jsphuebner/bms-hardware/README.md

# bms-hardware
Hardware design files for Lithium BMS

# License
Attribution-ShareAlike 4.0 International
https://creativecommons.org/licenses/by-sa/4.0/legalcode

You musn't change the copyright info (J. Huebner/A. Martell and openinverter.org) on the silkscreen in size location or content.
