jsphuebner/bms-hardware/BMS Slave Files/BatMeas5.3 Manufacturing Files/Assembly/BOM.csv

Qty | Value | SM / THT | Fitted (Y/N) | Device | Package | Parts | Description | Additional info | Manufacturer | Manufacturers Part Number | Comment | Mouser / Farnell
2 |  | SM | Y | DIODESOD-323F | SOD-323F | D2, D3 | Diode | Diode Signal 1N4148 | On Semiconductor | 1N4148WS |  | https://www.mouser.co.uk/ProductDetail/ON-Semiconductor-Fairchild/1N4148WS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
1 |  | SM | Y | CON-LSTC |  | X1_ | Chinese IDC connector | 4mm wire to board connector | LSTC | 4400W03J7923
1 |  | SM | Y | BM05B-PASS-1 |  | J4 | JST Connector |  | JST | BM05B-PASS-1-TFT(LF)(SN) |  | https://uk.farnell.com/jst-japan-solderless-terminals/bm05b-pass-1-tft-lf-sn/connector-header-5pos-1row-2mm/dp/2399310
1 |  | SM | N | CON-AVX |  | X1 | AVX IDC connector | 2.56mm wire to board connector | AVX | 9175003702996 |  | https://www.digikey.com/product-detail/en/avx-corporation/009175003702996/478-9530-1-ND/5015640
1 |  | SM | Y | PINHD-2X5 | 2X05 | JP1 | PIN HEADER | Header 10 way |  | 3020-10-0300-00 | Programming header | https://www.digikey.de/product-detail/de/cnc-tech/3020-10-0300-00/1175-1621-ND/3441727
1 | 47k | SM | Y | R-EU_R0603 | R0603 | R14 | RESISTOR, European symbol | Resistor 0603 100k 1% 100mW | Vishay | CRCW0603100KFKEA |  | https://lcsc.com/product-detail/Chip-Resistor-Surface-Mount_Uniroyal-Elec-0603WAF4702T5E_C25819.html/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
4 | 100n | SM | Y | C-EUC0603 | C0603 | C2, C3, C4 | CAPACITOR, European symbol | Capacitor 0603 100n 20% 25V | Kemet | C0603C104M3VACTU |  | https://www.mouser.co.uk/ProductDetail/KEMET/C0603C104M3VACTU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
1 | 10µ | SM | Y | C-EUC0805 | C0805 | C9 | CAPACITOR, European symbol | Capacitor 0805 10uF 10% 10V | Kemet | C0805C106K8PACTU |  | https://www.mouser.co.uk/ProductDetail/KEMET/C0805C106K8PACTU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
4 | 150060GS75000 | SM | Y | LEDCHIPLED_0805 | CHIPLED_0805 | LED1, LED2, LED3, LED4 | LED | LED 0805 Red | Wurth | 150080RS75000 |  | https://www.mouser.co.uk/ProductDetail/Wurth-Electronics/150080RS75000
1 | 1540k | SM | Y | R-EU_R0603 | R0603 | R8 | RESISTOR, European symbol | Resistor 0603 1540k 1% 100mW | Vishay | CRCW06031M54FKEA |  | https://www.mouser.co.uk/ProductDetail/Vishay-Dale/CRCW06031M54FKEA?qs=algJsbUzQnFVJ2u3pqZ3aw%3D%3D
4 | 1M | SM | Y | R-EU_R0603 | R0603 | R1, R2, R3, R4 | RESISTOR, European symbol | Resistor 0603 1M 1% 100mW | Vishay | CRCW06031M00FKEA |  | https://www.mouser.co.uk/ProductDetail/Vishay-Dale/CRCW06031M00FKEA
2 | 4k7 | SM | Y | R-EU_R0603 | R0603 | R6, R16 | RESISTOR, European symbol | Resistor 0603 1k 5% 100mW | Vishay | CRCW06031K00FKEA |  | https://lcsc.com/product-detail/Chip-Resistor-Surface-Mount_Uniroyal-Elec-0603WAF4701T5E_C23162.html/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
3 | 1µ | SM | Y | C-EUC0603 | C0603 | C1, C6, C7, C8 | CAPACITOR, European symbol | Capacitor 0603 1u 20% 25V | Kemet | C0603C105M3PACTU |  | https://www.mouser.co.uk/ProductDetail/KEMET/C0603C105M3PACTU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
1 | 20V | SM | Y | ZENER-DIODESMB | SMB | D1 | Z-Diode | Zener Diode SMB 20V 3W | On Semiconductor | 1SMB5932BT3G |  | https://www.mouser.co.uk/ProductDetail/ON-Semiconductor/1SMB5932BT3G?qs=sGAEpiMZZMtqO%252BWUGLBzeNjTlo8%2FRK9r
4 | 22 | SM | Y | R-EU_R0805 | R0805 | R19, R20, R21, R22 | RESISTOR, European symbol | Resistor 0805 22R 5% 125mW | Vishay | CRCW080522R0FKEA |  | https://www.mouser.co.uk/ProductDetail/Vishay-Dale/CRCW080522R0FKEA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
3 | 220 | SM | Y | R-EU_R0603 | R0603 | R11, R12, R13 | RESISTOR, European symbol | Resistor 0603 270R 5% 100mW | Vishay | CRCW0603270RFKEA | Used to be 270 | https://www.mouser.co.uk/ProductDetail/Vishay-Dale/CRCW0603270RFKEA
1 | 270k | SM | Y | R-EU_R0603 | R0603 | R7 | RESISTOR, European symbol | Resistor 0603 270k 1% 100mW | Vishay | CRCW0603270KFKEA |  | https://www.mouser.co.uk/ProductDetail/Vishay-Dale/CRCW0603270KFKEA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
1 | 2M8 | SM | Y | R-EU_R0603 | R0603 | R9 | RESISTOR, European symbol | Resistor 0603 2M8 1% 100mW | Vishay | CRCW06032M80FKEA |  | https://www.mouser.co.uk/ProductDetail/Vishay-Dale/CRCW06032M80FKEA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
1 | 3V | SM | Y | V_REG_LDOSMD | SOT23-5 | IC3 | Voltage Regulator LDO | Regulator LDO SOT23-5 3V 300mA | Microchip | AP2139AK-3.0TRG1 | AP2139AK-3.0TRG1 has less GND current (1µA vs. 50µA) but costs twice as much as MIC5501-3.0YM5-TR, but gnd current important | https://www.mouser.co.uk/ProductDetail/Diodes-Incorporated/AP2139AK-30TRG1
1 | 3V3 | SM | Y | V_REG_LDOSMD | SOT23-5 | IC2 | Voltage Regulator LDO | Regulator LDO SOT23-5 3V3 300mA | Microchip | AP2204K-3.3TRG1 | Must have > 20V input voltage | https://www.mouser.co.uk/ProductDetail/Diodes-Incorporated/AP2139AK-30TRG1
1 | 4M12 | SM | Y | R-EU_R0603 | R0603 | R10 | RESISTOR, European symbol | Resistor 0603 4M12 1% 100mW | Vishay | CRCW06034M12FKEA |  | https://www.mouser.co.uk/ProductDetail/Vishay-Dale/CRCW06034M12FKEA
1 | 1n | SM | Y | C-EUC0603 | C0603 | C5 | CAPACITOR, European symbol | Capacitor 0603 1n 20% 25V | Kemet | C0603C103K4RECAUTO |  | https://lcsc.com/product-detail/Multilayer-Ceramic-Capacitors-MLCC-SMD-SMT_SAMSUNG_CL10B102KB8NNNC_1nF-102-10-50V_C1588.html/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
1 | ATTINY44A-SSU | SM | Y | ATTINY44 | SO014 | IC1 |  | Microcontroller ATTINYxxxx | Microchip / Atmel | ATTINY44A-SSU |  | https://www.mouser.de/ProductDetail/Microchip-Technology-Atmel/ATTINY44A-SSU
3 | MMUN2111LT1G | SM | Y | MUN2111T1-PNP_DRIVER-SC59-B | EC SC59-BEC | T4, T5, T6 | PNP Bias Resistor Transistor | Transistor PNP | On Semiconductor | MMUN2111LT1G |  | https://www.mouser.co.uk/ProductDetail/ON-Semiconductor/MMUN2111LT1G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
5 | MMUN2233 | SM | Y | MUN2211T1-NPN_DRIVER-SC59-B | EC SC59-BEC | T1, T2, T3, T7, T8 | NPN Bias Resistor Transistor | Transistor NPN | On Semiconductor | MMUN2233LT1G |  | https://www.mouser.co.uk/ProductDetail/ON-Semiconductor/MMUN2233LT1G
1 |  | SM | Y | Jumper |  | JP1 | Board position selection |  | Sullins | QPC02SXGN-RC | Place on JP1 Pins 2-4 by default. Must be moved to Pins 4-6 on first board | https://www.digikey.de/product-detail/de/sullins-connector-solutions/QPC02SXGN-RC/S9337-ND/2618262
 |  | 48 SMT Parts
 |  | 24 Different SMT parts
 |  |  |  |  |  |  |  |  | Mating parts
 |  |  |  |  |  |  |  |  | JST | PAP-03V-S |  | https://uk.farnell.com/jst-japan-solderless-terminals/pap-03v-s/connector-housing-pa-3way-2mm/dp/1830728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
 |  |  |  |  |  |  |  |  | JST | PAP-05V-S |  | https://uk.farnell.com/jst-japan-solderless-terminals/pap-05v-s/connector-housing-rcpt-5pos-1row/dp/2399185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
 |  |  |  |  |  |  |  |  | JST | SPHD-002T-P0.5 | 28-24AWG | https://uk.farnell.com/jst-japan-solderless-terminals/sphd-002t-p0-5/crimp-socket-24-28awg/dp/1830725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
 |  |  |  |  |  |  |  |  | Crimp tool | SN-28B | Something like this from Ebay | https://www.ebay.co.uk/itm/SN-28B-2-54mm-3-96mm-Pin-Crimp-Plier-Tool-18-28AWG-Crimper-for-Dupont-JST-UK/123777029100
