jsphuebner/bms-hardware/BatMeas5.2.csv

Qty | Value | SM / THT | Fitted (Y/N) | Device | Package | Parts | Description | Additional info | Fitted? | Manufacturer | Manufacturers Part Number | Comment | Mouser / Farnell
1 |  | SM | Y | DIODESOD-323F | SOD-323F | D2 | Diode | Diode Signal 1N4148 | Y | On Semiconductor | 1N4148WS |  | https://www.mouser.co.uk/ProductDetail/ON-Semiconductor-Fairchild/1N4148WS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
1 |  | SM | Y | DIODESOD-323F | SOD-323F | D3 | Zener Diode | Zener Diode SOD-323 3V 300mW | Y | On Semiconductor | MM3Z3V0ST1G
1 |  | SM | Y | BM03B-PASS-1 |  | J4 | JST Connector |  | Y | JST | BM03B-PASS-1-TFT(LF)(SN) |  | https://uk.farnell.com/jst-japan-solderless-terminals/bm03b-pass-1-tft-lf-sn/connector-header-3pos-1row-2mm/dp/2399307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
1 |  | SM | Y | BM05B-PASS-1 |  | J3 | JST Connector |  | Y | JST | BM05B-PASS-1-TFT(LF)(SN) |  | https://uk.farnell.com/jst-japan-solderless-terminals/bm05b-pass-1-tft-lf-sn/connector-header-5pos-1row-2mm/dp/2399310
1 |  | THT | N | MTA03-100 | 10X03MTA | J2 | AMP connector | Connector 3 pole | N
1 |  | THT | N | MTA05-100 | 10X05MTA | J1 | AMP connector | Connector 5 pole | N
1 |  | THT | N | PINHD-2X5 | 2X05 | JP1 | PIN HEADER | Header 10 way | N |  |  | Programming header - not fitted
1 | 100k | SM | Y | R-EU_R0603 | R0603 | R14 | RESISTOR, European symbol | Resistor 0603 100k 1% 100mW | Y | Vishay | CRCW0603100KFKEA |  | https://www.mouser.co.uk/ProductDetail/Vishay-Dale/CRCW0603100KFKEA
4 | 100n | SM | Y | C-EUC0603 | C0603 | C2, C3, C4, C6 | CAPACITOR, European symbol | Capacitor 0603 100n 20% 25V | Y | Kemet | C0603C104M3VACTU |  | https://www.mouser.co.uk/ProductDetail/KEMET/C0603C104M3VACTU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
1 | 10µ | SM | Y | C-EUC0805 | C0805 | C9 | CAPACITOR, European symbol | Capacitor 0805 10uF 10% 10V | Y | Kemet | C0805C106K8PACTU |  | https://www.mouser.co.uk/ProductDetail/KEMET/C0805C106K8PACTU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
4 | 150060GS75000 | SM | Y | LEDCHIPLED_0805 | CHIPLED_0805 | LED1, LED2, LED3, LED4 | LED | LED 0805 Red | Y | Wurth | 150080RS75000 |  | https://www.mouser.co.uk/ProductDetail/Wurth-Electronics/150080RS75000
1 | 1540k | SM | Y | R-EU_R0603 | R0603 | R8 | RESISTOR, European symbol | Resistor 0603 1540k 1% 100mW | Y | Vishay | CRCW06031M54FKEA |  | https://www.mouser.co.uk/ProductDetail/Vishay-Dale/CRCW06031M54FKEA?qs=algJsbUzQnFVJ2u3pqZ3aw%3D%3D
4 | 1M | SM | Y | R-EU_R0603 | R0603 | R1, R2, R3, R4 | RESISTOR, European symbol | Resistor 0603 1M 1% 100mW | Y | Vishay | CRCW06031M00FKEA |  | https://www.mouser.co.uk/ProductDetail/Vishay-Dale/CRCW06031M00FKEA
2 | 1k | SM | Y | R-EU_R0603 | R0603 | R6, R13 | RESISTOR, European symbol | Resistor 0603 1k 5% 100mW | Y | Vishay | CRCW06031K00FKEA | Remove R6 on first board | https://www.mouser.co.uk/ProductDetail/Vishay-Dale/CRCW06031K00FKEA
1 | 1k | SM | N | R-EU_R0603 | R0603 | R5 | RESISTOR, European symbol | Resistor 0603 1k 5% 100mW | Y | Vishay | CRCW06031K00FKEA | Do not populate R5, only on first board in UK. | https://www.mouser.co.uk/ProductDetail/Vishay-Dale/CRCW06031K00FKEA
1 | 1µ | SM | Y | C-EUC0603 | C0603 | C1 | CAPACITOR, European symbol | Capacitor 0603 1u 20% 25V | Y | Kemet | C0603C105M3PACTU |  | https://www.mouser.co.uk/ProductDetail/KEMET/C0603C105M3PACTU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
1 | 1µ | SM | Y | C-EUC0805 | C0805 | C8 | CAPACITOR, European symbol | Capacitor 0805 1uF 20% 10V | Y | Kemet | C0805C105K8RAC |  | https://www.mouser.co.uk/ProductDetail/KEMET/C0805C105K8RAC
1 | 20V | SM | Y | ZENER-DIODESMB | SMB | D1 | Z-Diode | Zener Diode SMB 20V 3W | Y | On Semiconductor | 1SMB5932BT3G |  | https://www.mouser.co.uk/ProductDetail/ON-Semiconductor/1SMB5932BT3G?qs=sGAEpiMZZMtqO%252BWUGLBzeNjTlo8%2FRK9r
4 | 22 | SM | Y | R-EU_R0805 | R0805 | R19, R20, R21, R22 | RESISTOR, European symbol | Resistor 0805 22R 5% 125mW | Y | Vishay | CRCW080522R0FKEA |  | https://www.mouser.co.uk/ProductDetail/Vishay-Dale/CRCW080522R0FKEA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
2 | 270 | SM | Y | R-EU_R0603 | R0603 | R11, R12 | RESISTOR, European symbol | Resistor 0603 270R 5% 100mW | Y | Vishay | CRCW0603270RFKEA |  | https://www.mouser.co.uk/ProductDetail/Vishay-Dale/CRCW0603270RFKEA
1 | 270k | SM | Y | R-EU_R0603 | R0603 | R7 | RESISTOR, European symbol | Resistor 0603 270k 1% 100mW | Y | Vishay | CRCW0603270KFKEA |  | https://www.mouser.co.uk/ProductDetail/Vishay-Dale/CRCW0603270KFKEA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
1 | 2M8 | SM | Y | R-EU_R0603 | R0603 | R9 | RESISTOR, European symbol | Resistor 0603 2M8 1% 100mW | Y | Vishay | CRCW06032M80FKEA |  | https://www.mouser.co.uk/ProductDetail/Vishay-Dale/CRCW06032M80FKEA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
1 | 3V | SM | Y | V_REG_LDOSMD | SOT23-5 | IC3 | Voltage Regulator LDO | Regulator LDO SOT23-5 3V 300mA | Y | Microchip | AP2139AK-3.0TRG1 | AP2139AK-3.0TRG1 has less GND current (1µA vs. 50µA) but costs twice as much as MIC5501-3.0YM5-TR, but gnd current important | https://www.mouser.co.uk/ProductDetail/Diodes-Incorporated/AP2139AK-30TRG1
1 | 3V3 | SM | Y | V_REG_LDOSMD | SOT23-5 | IC2 | Voltage Regulator LDO | Regulator LDO SOT23-5 3V3 300mA | Y | Microchip | AP2204K-3.3TRG1 | Must have > 20V input voltage | https://www.mouser.co.uk/ProductDetail/Diodes-Incorporated/AP2139AK-30TRG1
1 | 4M12 | SM | Y | R-EU_R0603 | R0603 | R10 | RESISTOR, European symbol | Resistor 0603 4M12 1% 100mW | Y | Vishay | CRCW06034M12FKEA |  | https://www.mouser.co.uk/ProductDetail/Vishay-Dale/CRCW06034M12FKEA
1 | 4k7 | SM | Y | R-EU_R0603 | R0603 | R16 | RESISTOR, European symbol | Resistor 0603 4k7 5% 100mW | Y | Vishay | CRCW06034K70FKEB | In stock in mouser | https://www.mouser.co.uk/ProductDetail/Vishay-Dale/CRCW06034K70FKEB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
1 | 4n7 | SM | Y | C-EUC0603 | C0603 | C5 | CAPACITOR, European symbol | Capacitor 0603 4n7 20% 25V | Y | Kemet | C0603C472K3RACTU |  | https://www.mouser.co.uk/ProductDetail/KEMET/C0603C472K3RACTU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
1 | ATTINY84A-SSU | SM | Y | ATTINY24 | SO014 | IC1 |  | Microcontroller ATTINYxxxx | Y | Microchip / Atmel | ATTINY84A-SSU |  | https://www.mouser.co.uk/ProductDetail/Microchip-Technology-Atmel/ATTINY84A-SSU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
3 | MMUN2111LT1G | SM | Y | MUN2111T1-PNP_DRIVER-SC59-B | EC SC59-BEC | T4, T5, T6 | PNP Bias Resistor Transistor | Transistor PNP | Y | On Semiconductor | MMUN2111LT1G |  | https://www.mouser.co.uk/ProductDetail/ON-Semiconductor/MMUN2111LT1G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
5 | MMUN2233 | SM | Y | MUN2211T1-NPN_DRIVER-SC59-B | EC SC59-BEC | T1, T2, T3, T7, T8 | NPN Bias Resistor Transistor | Transistor NPN | Y | On Semiconductor | MMUN2233LT1G |  | https://www.mouser.co.uk/ProductDetail/ON-Semiconductor/MMUN2233LT1G
 |  | 47 SMT Parts
 |  | 27 Different SMT parts
 |  |  |  |  |  |  |  |  |  | Mating parts
 |  |  |  |  |  |  |  |  |  | JST | PAP-03V-S |  | https://uk.farnell.com/jst-japan-solderless-terminals/pap-03v-s/connector-housing-pa-3way-2mm/dp/1830728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
 |  |  |  |  |  |  |  |  |  | JST | PAP-05V-S |  | https://uk.farnell.com/jst-japan-solderless-terminals/pap-05v-s/connector-housing-rcpt-5pos-1row/dp/2399185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
 |  |  |  |  |  |  |  |  |  | JST | SPHD-002T-P0.5 | 28-24AWG | https://uk.farnell.com/jst-japan-solderless-terminals/sphd-002t-p0-5/crimp-socket-24-28awg/dp/1830725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
 |  |  |  |  |  |  |  |  |  | Crimp tool | SN-28B | Something like this from Ebay | https://www.ebay.co.uk/itm/SN-28B-2-54mm-3-96mm-Pin-Crimp-Plier-Tool-18-28AWG-Crimper-for-Dupont-JST-UK/123777029100
