jsphuebner/bms-hardware/Isolator Files/CAN Isolator SMT/CAN Isolator V2/Isolator CAN SMT v2.pdf

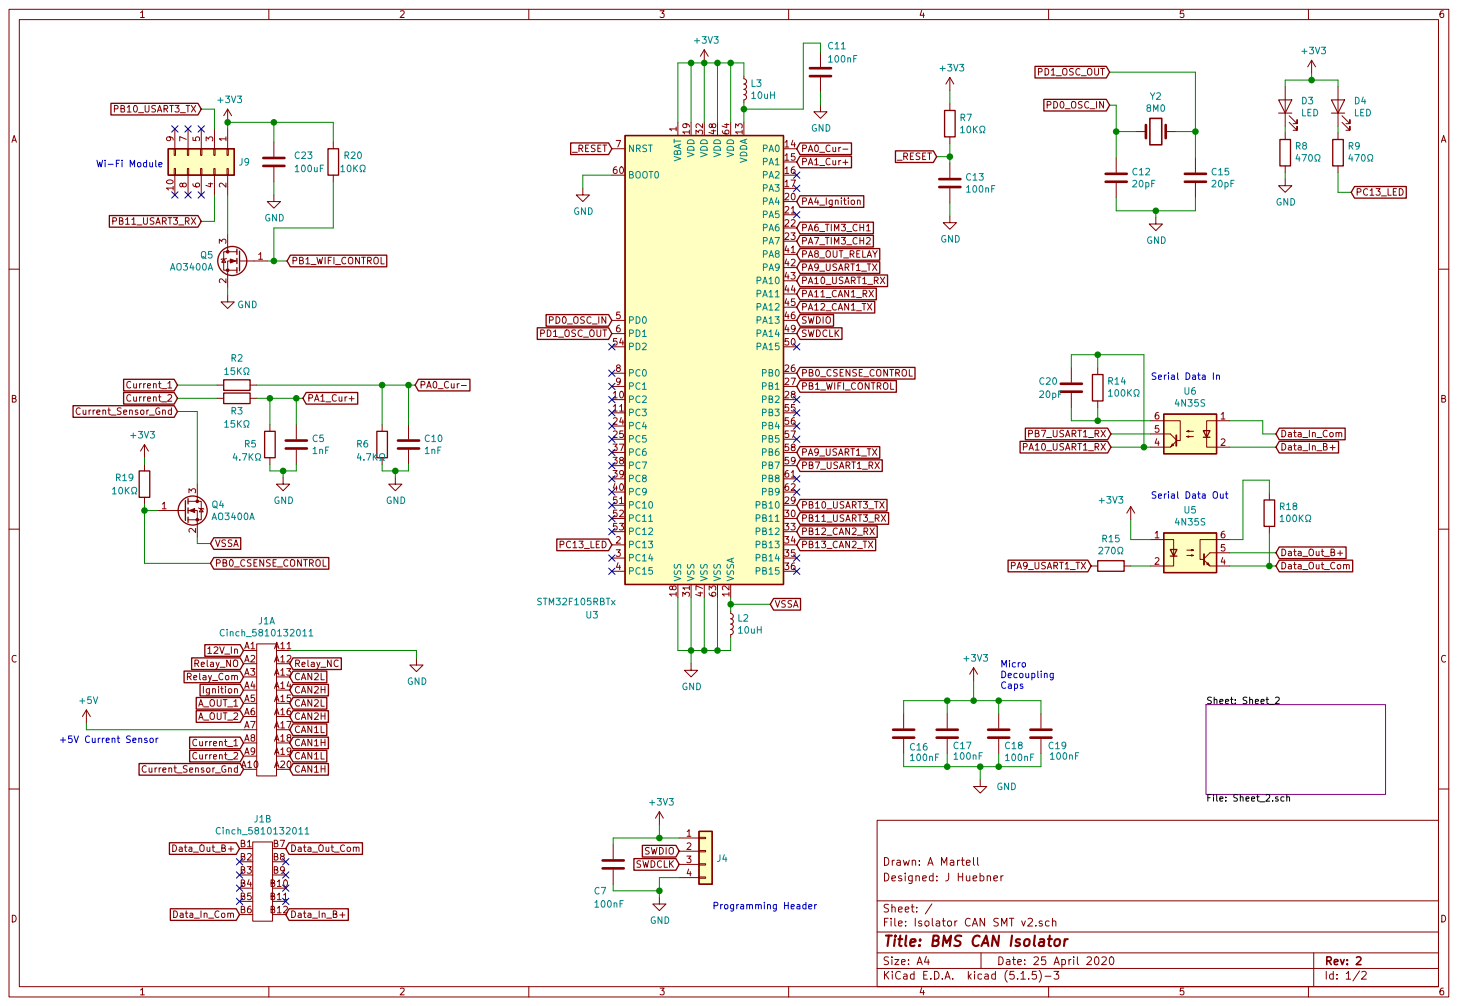
[picture p1: page 1]

1 VDD 19 VDD 32 VDD 48 VDD 64 VDDA 13 VSS 18 VSS 31 VSS 47 VSS 63 VSSA 12 U3 STM32F105RBTx GND

Serial Data In Serial Data Out Wi-Fi Module

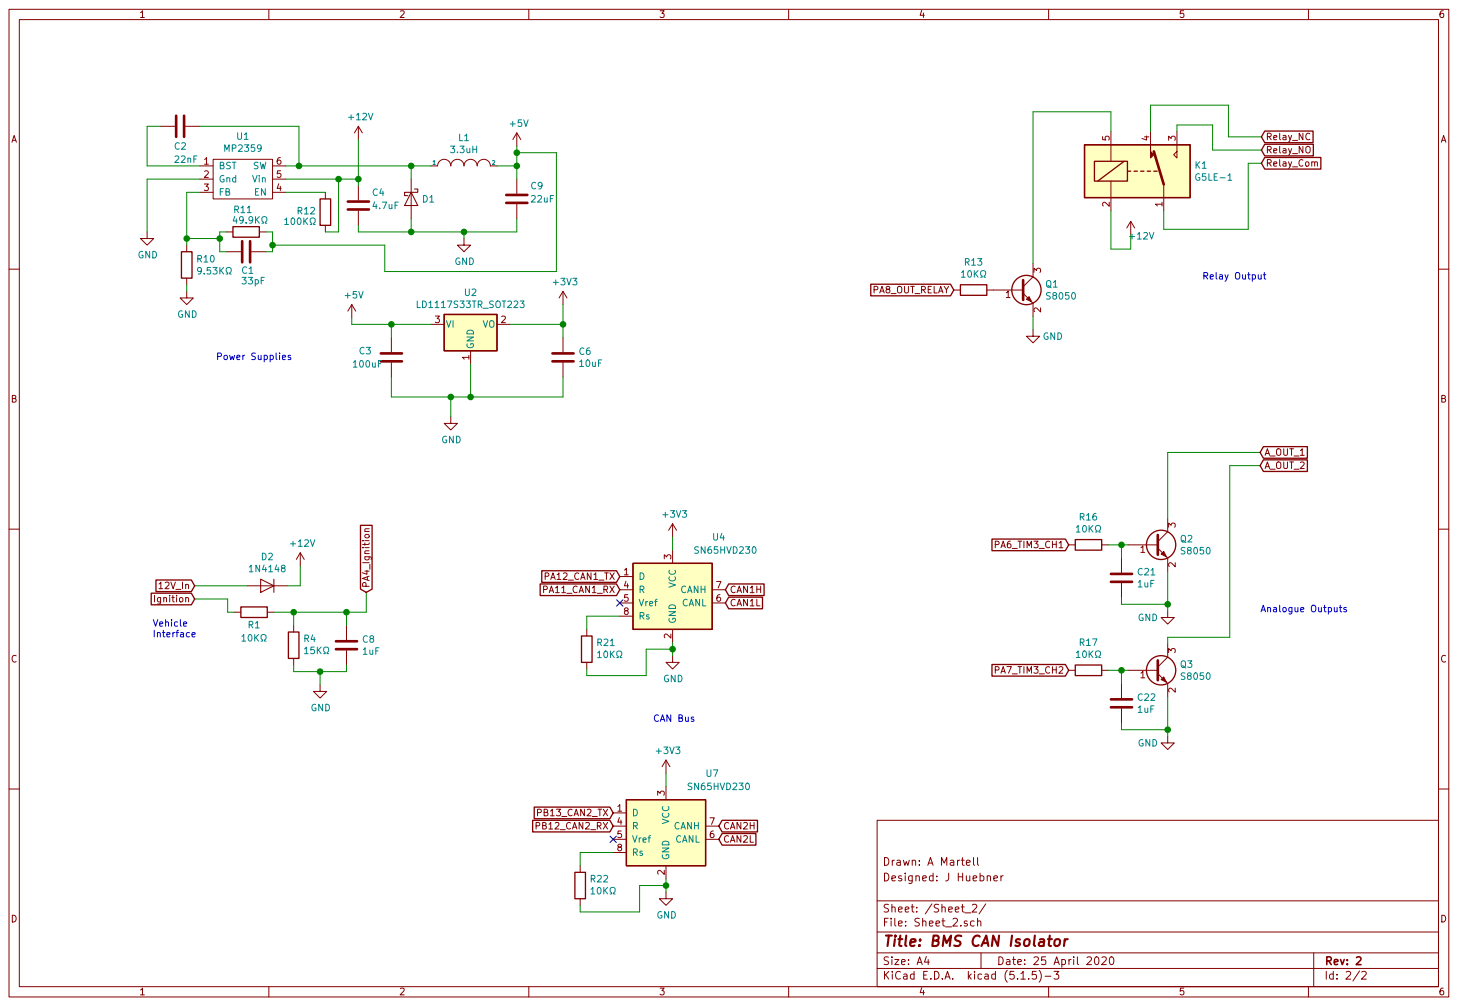
[picture p2: page 2]

Designed: J Huebner Drawn: A Martell

Sheet: /Sheet_2/
File: Sheet_2.sch
Id: 2/2 Title: BMS CAN Isolator
