jsphuebner/bms-hardware/BatMeas5.2 JST.pdf

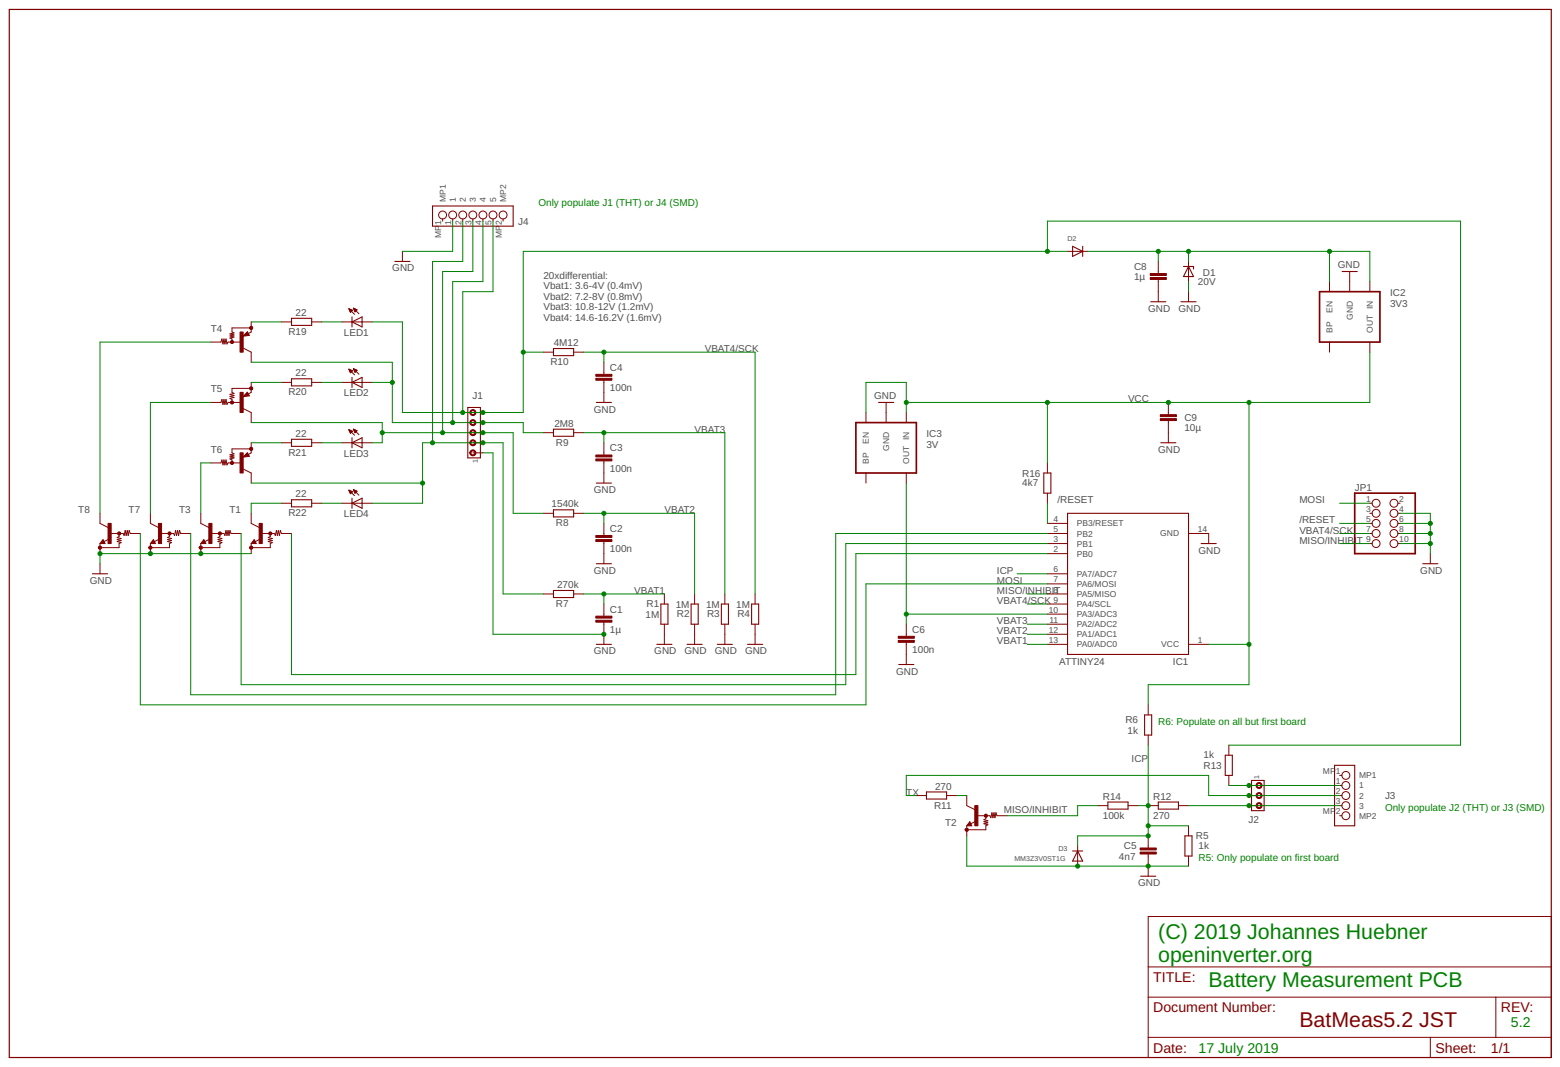
[picture p3: page 1]
