jsphuebner/bms-hardware/Isolator Files/RS485 Isolator/Isolator2.0.pdf

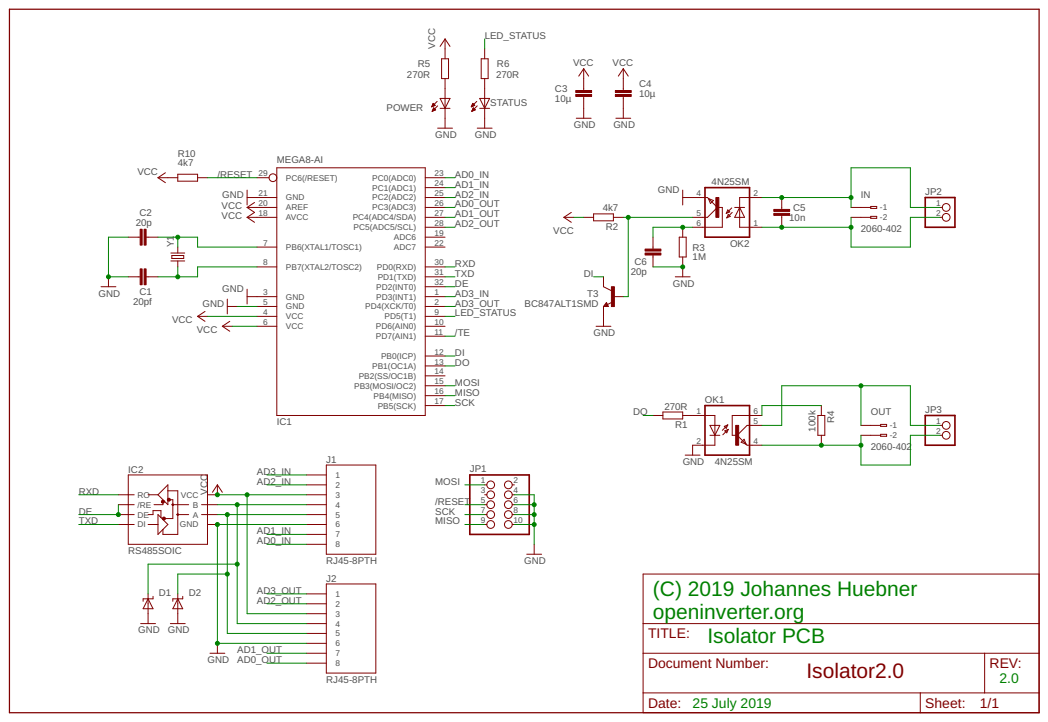
[picture p4: page 1]

Document Number: Isolator2.0 | REV: 2.0

Date: 25 July 2019 | Sheet: 1/1
