jsphuebner/bms-hardware/Isolator Files/CAN Isolator SMT/CAN Isolator V2/Isolator CAN SMT v2.kicad_pcb

## KiCad design Isolator Files/CAN Isolator SMT/CAN Isolator V2/Isolator CAN SMT v2.kicad_pcb (2020-05-03)

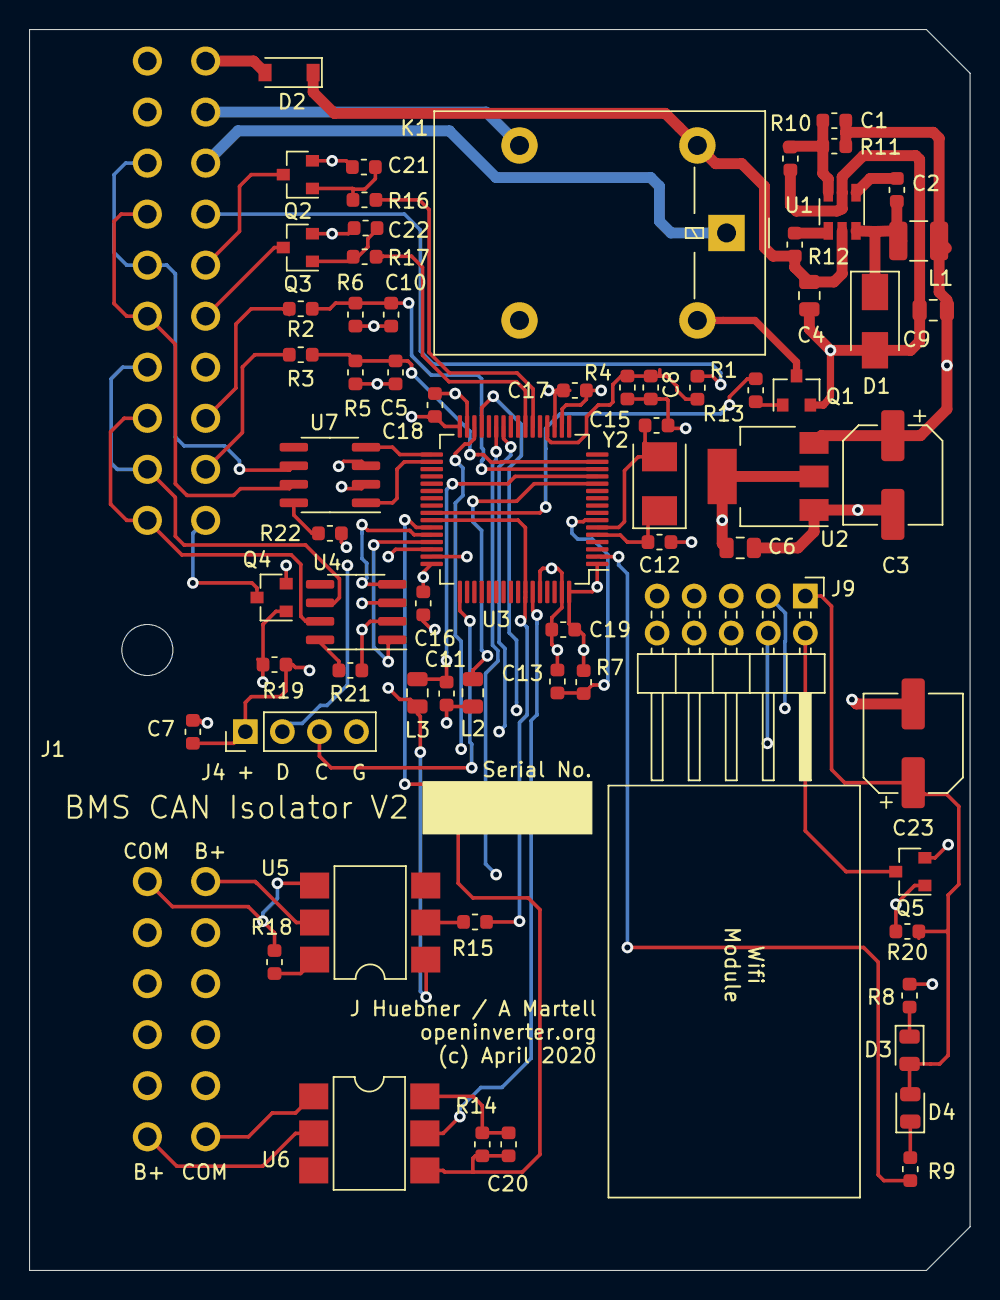
[picture p5: board Isolator CAN SMT v2.kicad_pcb from above]

Board: 4 copper layers, 64.5 x 85.1 mm, 68 parts (0 on the bottom side), 63 nets.

Parts:
C1: 33pF; C_0603_1608Metric
C2: 22nF; C_0603_1608Metric
C3, C23: 100uF; CP_Elec_6.3x7.7
C4: 4.7uF; C_0805_2012Metric
C5, C10: 1nF; C_0603_1608Metric
C6: 10uF; C_0805_2012Metric
C7, C11, C13, C16, C17, C18, C19: 100nF; C_0603_1608Metric
C8, C21, C22: 1uF; C_0603_1608Metric
C9: 22uF; C_0805_2012Metric
C12, C15, C20: 20pF; C_0603_1608Metric
D1: D_Schottky; D_SMA
D2: 1N4148; D_SOD-123
D3, D4: LED; LED_0805_2012Metric
J1: Cinch_5810132011; Cinch_581_01_32_011
J4: Conn_01x04; PinHeader_1x04_P2.54mm_Vertical
J9: Conn_02x05_Odd_Even; PinHeader_2x05_P2.54mm_Horizontal
K1: G5LE-1; Relay_SPDT_Omron-G5LE-1
L1: 3.3uH; L_1210_3225Metric
L2, L3: 10uH; L_0805_2012Metric
Q1, Q2, Q3: S8050; SOT-23
Q4, Q5: AO3400A; SOT-23
R1, R7, R13, R16, R17, R19, R20, R21, R22: 10KΩ; R_0603_1608Metric
R2, R3, R4: 15KΩ; R_0603_1608Metric
R5, R6: 4.7KΩ; R_0603_1608Metric
R8, R9: 470Ω; R_0603_1608Metric
R10: 9.53KΩ; R_0603_1608Metric
R11: 49.9KΩ; R_0603_1608Metric
R12, R14, R18: 100KΩ; R_0603_1608Metric
R15: 270Ω; R_0603_1608Metric
U1: MP2359; TSOT-23-6
U2: LD1117S33TR_SOT223; SOT-223-3_TabPin2
U3: STM32F105RBTx; LQFP-64_10x10mm_P0.5mm
U4, U7: SN65HVD230; SOIC-8_3.9x4.9mm_P1.27mm
U5, U6: 4N35S; SMDIP-6_W7.62mm
Y2: 8M0; Crystal_SMD_5032-2Pin_5.0x3.2mm

Connections:
12V_In: D2.2, J1.A1
+3V3: C6.1, C7.1, C16.1, C17.1, C18.1, C19.1, C23.1, D3.2, D4.2, J4.1, J9.1, L3.1, R7.1, R19.1, R20.1, U2.2, U3.1, U3.19, U3.32, U3.48, U3.64, U4.3, U5.1, U7.3
+5V: C1.1, C3.1, C9.1, J1.A7, L1.2, R11.1, U2.3
+12V: C4.1, D2.1, K1.2, R12.2, U1.5
A_OUT_1: J1.A5, Q2.3
A_OUT_2: J1.A6, Q3.3
CAN1H: J1.A18, J1.A20, U4.7
CAN1L: J1.A17, J1.A19, U4.6
CAN2H: J1.A14, J1.A16, U7.7
CAN2L: J1.A13, J1.A15, U7.6
Current_1: J1.A8, R2.1
Current_2: J1.A9, R3.1
Current_Sensor_Gnd: J1.A10, Q4.3
Data_In_B+: J1.B12, U6.2
Data_In_Com: J1.B6, U6.1
Data_Out_B+: J1.B1, U5.5
Data_Out_Com: J1.B7, R18.1, U5.4
GND: C3.2, C4.2, C5.2, C6.2, C7.2, C8.2, C9.2, C10.2, C11.2, C12.2, C13.2, C15.2, C16.2, C17.2, C18.2, C19.2, C21.2, C22.2, C23.2, D1.2, J1.A11, J4.4, L2.2, Q1.2, Q2.2, Q3.2, Q5.2, R4.1, R5.1, R6.1, R8.1, R10.2, R21.1, R22.1, U1.2, U2.1, U3.18, U3.31, U3.47, U3.60, U3.63, U4.2, U7.2
Ignition: J1.A4, R1.1
unnamed: C1.2, R10.1, R11.2, U1.3
unnamed: C2.1, D1.1, L1.1, U1.6
unnamed: C2.2, U1.1
unnamed: C11.1, L3.2, U3.13
unnamed: C20.2, R14.1, U6.6
unnamed: C21.1, Q2.1, R16.2
unnamed: C22.1, Q3.1, R17.2
unnamed: D3.1, R8.2
unnamed: D4.1, R9.2
unnamed: J9.2, Q5.3
unnamed: K1.5, Q1.3
unnamed: Q1.1, R13.2
unnamed: R12.1, U1.4
unnamed: R15.1, U5.2
unnamed: R18.2, U5.6
unnamed: R21.2, U4.8
unnamed: R22.2, U7.8
PA0_Cur-: C10.1, R2.2, R6.2, U3.14
PA1_Cur+: C5.1, R3.2, R5.2, U3.15
PA4_Ignition: C8.1, R1.2, R4.2, U3.20
PA6_TIM3_CH1: R16.1, U3.22
PA7_TIM3_CH2: R17.1, U3.23
PA8_OUT_RELAY: R13.1, U3.41
PA9_USART1_TX: R15.2, U3.42, U3.58
PA10_USART1_RX: C20.1, R14.2, U3.43, U6.4
PA11_CAN1_RX: U3.44, U4.4
PA12_CAN1_TX: U3.45, U4.1
PB0_CSENSE_CONTROL: Q4.1, R19.2, U3.26
PB1_WIFI_CONTROL: Q5.1, R20.2, U3.27
PB7_USART1_RX: U3.59, U6.5
PB10_USART3_TX: J9.3, U3.29
PB11_USART3_RX: J9.4, U3.30
PB12_CAN2_RX: U3.33, U7.4
PB13_CAN2_TX: U3.34, U7.1
PC13_LED: R9.1, U3.2
PD0_OSC_IN: C12.1, U3.5, Y2.1
PD1_OSC_OUT: C15.1, U3.6, Y2.2
Relay_Com: J1.A3, K1.1
Relay_NC: J1.A12, K1.4
Relay_NO: J1.A2, K1.3
SWDCLK: J4.3, U3.49
SWDIO: J4.2, U3.46
VSSA: L2.1, Q4.2, U3.12
_RESET: C13.1, R7.2, U3.7
