jsphuebner/bms-hardware/BMS Slave Files/BatMeas5.3 JST.brd

## EAGLE design BMS Slave Files/BatMeas5.3 JST.brd (2020-05-02)

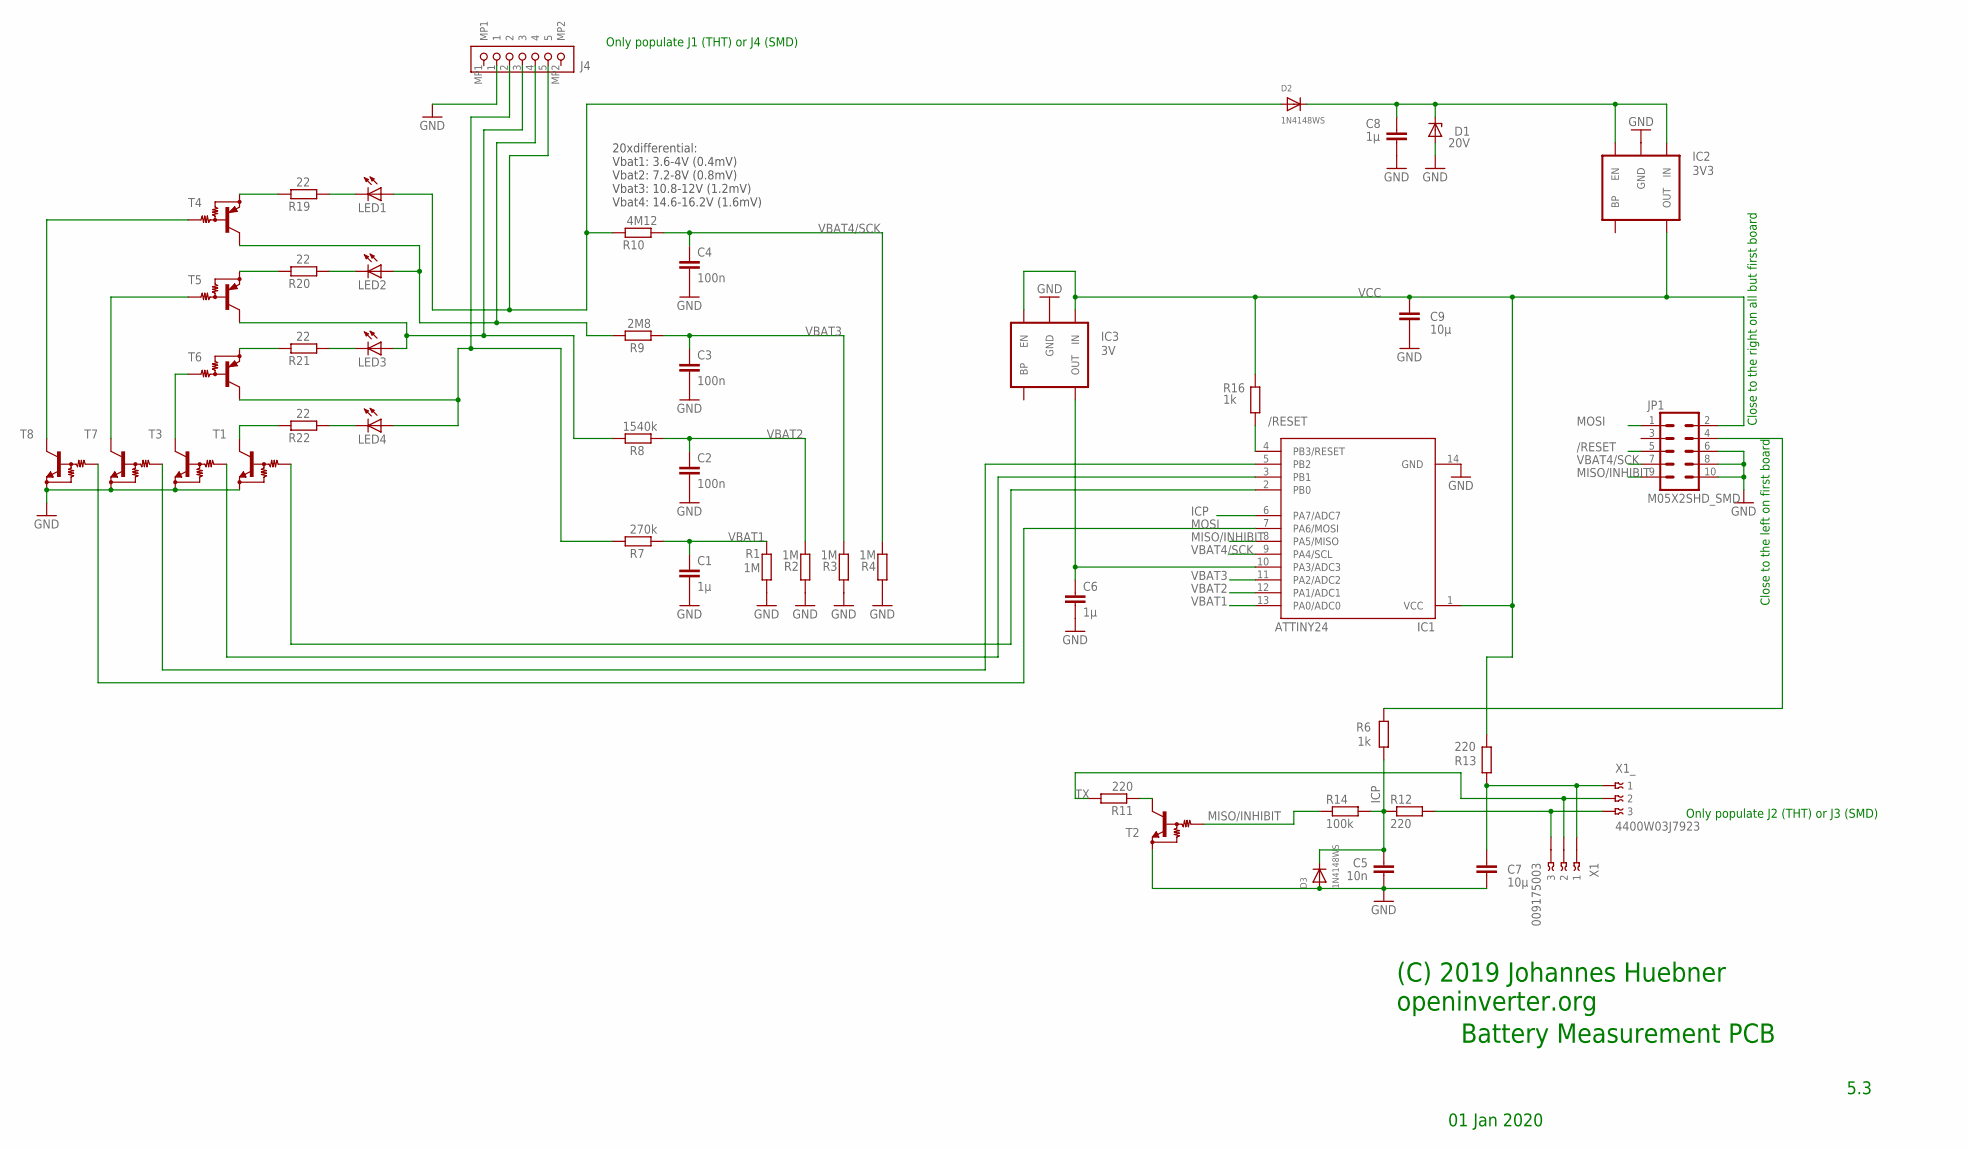
[picture p6: schematic BatMeas5.3 JST.sch]

Parts:
C1, C6: 1µ; C0603
C2, C3, C4: 100n; C0603
C5: 10n; C0603
C7, C9: 10µ; C0805
C8: 1µ; C0805
D1: 20V; SMB
D2, D3: 1N4148WS; SOD-323F
IC1: ATTINY24; SO014
IC2: 3V3; SOT23-5
IC3: 3V; SOT23-5
J4: BM05B-PASS-1-TFT_(LF)(SN)SMD; BM05BPASS1TFTLFSN
JP1: M05X2SHD_SMD; 2X5-SHROUDED_SMD
LED1, LED2, LED3, LED4: 150060GS75000; CHIPLED_0805
R1, R2, R3, R4: 1M; R0603
R6, R16: 1k; R0603
R7: 270k; R0603
R8: 1540k; R0603
R9: 2M8; R0603
R10: 4M12; R0603
R11, R12, R13: 220; R0603
R14: 100k; R0603
R19, R20, R21, R22: 22; R0805
T1, T2, T3, T7, T8: MMUN2233; SC59-BEC
T4, T5, T6: MMUN2111LT1G; SC59-BEC
X1: 009175003
X1_: 4400W03J7923; 4400WXXJ7923

Connections:
/RESET: IC1.4 (PB3/RESET), JP1.5, R16.2
GND: C1.2, C2.2, C3.2, C4.2, C5.2, C6.2, C7.2, C8.2, C9.2, D1.A, D3.A, IC1.14 (GND), IC2.2 (GND), IC3.2 (GND), J4.1, JP1.6, JP1.8, JP1.10, R1.2, R2.2, R3.2, R4.2, T1.E, T2.E, T3.E, T7.E, T8.E
ICP: C5.1, D3.C, IC1.6 (PA7/ADC7), R6.1, R12.1, R14.2
MISO/INHIBIT: IC1.8 (PA5/MISO), JP1.9, R14.1, T2.B
MOSI: IC1.7 (PA6/MOSI), JP1.1, T8.B
unnamed: T3.C, T6.B
unnamed: C6.1, IC1.10 (PA3/ADC3), IC3.5 (OUT)
unnamed: IC1.2 (PB0), T1.B
unnamed: IC1.3 (PB1), T3.B
unnamed: R19.2, T4.E
unnamed: LED1.C, R19.1
unnamed: JP1.4, R6.2
unnamed: IC1.5 (PB2), T7.B
unnamed: R20.2, T5.E
unnamed: C7.1, R13.2, X1.1@1 (1), X1_.P$1 (1)
unnamed: LED2.C, R20.1
unnamed: R11.1, T2.C
unnamed: D2.A, J4.5, LED1.A, R10.2
unnamed: LED3.C, R21.1
unnamed: LED4.C, R22.1
unnamed: R21.2, T6.E
unnamed: R22.2, T1.C
unnamed: R12.2, X1.3@2 (3), X1_.P$3 (3)
unnamed: J4.4, LED2.A, R9.2, T4.C
unnamed: J4.3, LED3.A, R8.2, T5.C
unnamed: J4.2, LED4.A, R7.2, T6.C
unnamed: T5.B, T7.C
unnamed: T4.B, T8.C
TX: R11.2, X1.2@1 (2), X1_.P$2 (2)
VBAT: C8.1, D1.C, D2.C, IC2.1 (IN), IC2.3 (EN)
VBAT1: C1.1, IC1.13 (PA0/ADC0), R1.1, R7.1
VBAT2: C2.1, IC1.12 (PA1/ADC1), R2.1, R8.1
VBAT3: C3.1, IC1.11 (PA2/ADC2), R3.1, R9.1
VBAT4/SCK: C4.1, IC1.9 (PA4/SCL), JP1.7, R4.1, R10.1
VCC: C9.1, IC1.1 (VCC), IC2.5 (OUT), IC3.1 (IN), IC3.3 (EN), JP1.2, R13.1, R16.1

Notes on the sheet:
20xdifferential: Vbat1: 3.6-4V (0.4mV) Vbat2: 7.2-8V (0.8mV) Vbat3: 10.8-12V (1.2mV) Vbat4: 14.6-16.2V (1.6mV)
Close to the right on all but first board
5.3
(C) 2019 Johannes Huebner openinverter.org
Battery Measurement PCB
01 Jan 2020
Only populate J2 (THT) or J3 (SMD)
Only populate J1 (THT) or J4 (SMD)
Close to the left on first board

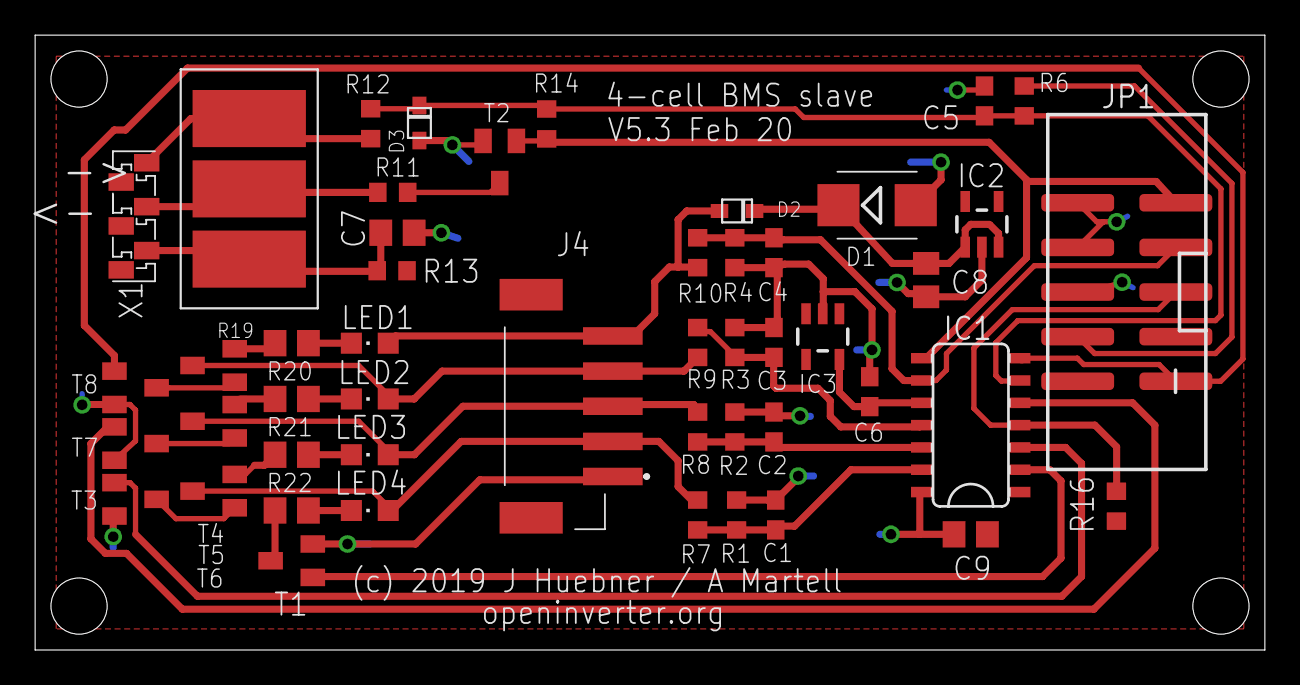
[picture p7: board BatMeas5.3 JST.brd from above]

Board: 2 copper layers, 70.0 x 35.0 mm, 49 parts (0 on the bottom side), 35 nets.
