jsphuebner/bms-hardware/Isolator Files/RS485 Isolator/Isolator2.0.brd

## EAGLE design Isolator Files/RS485 Isolator/Isolator2.0.brd (2019-07-22)

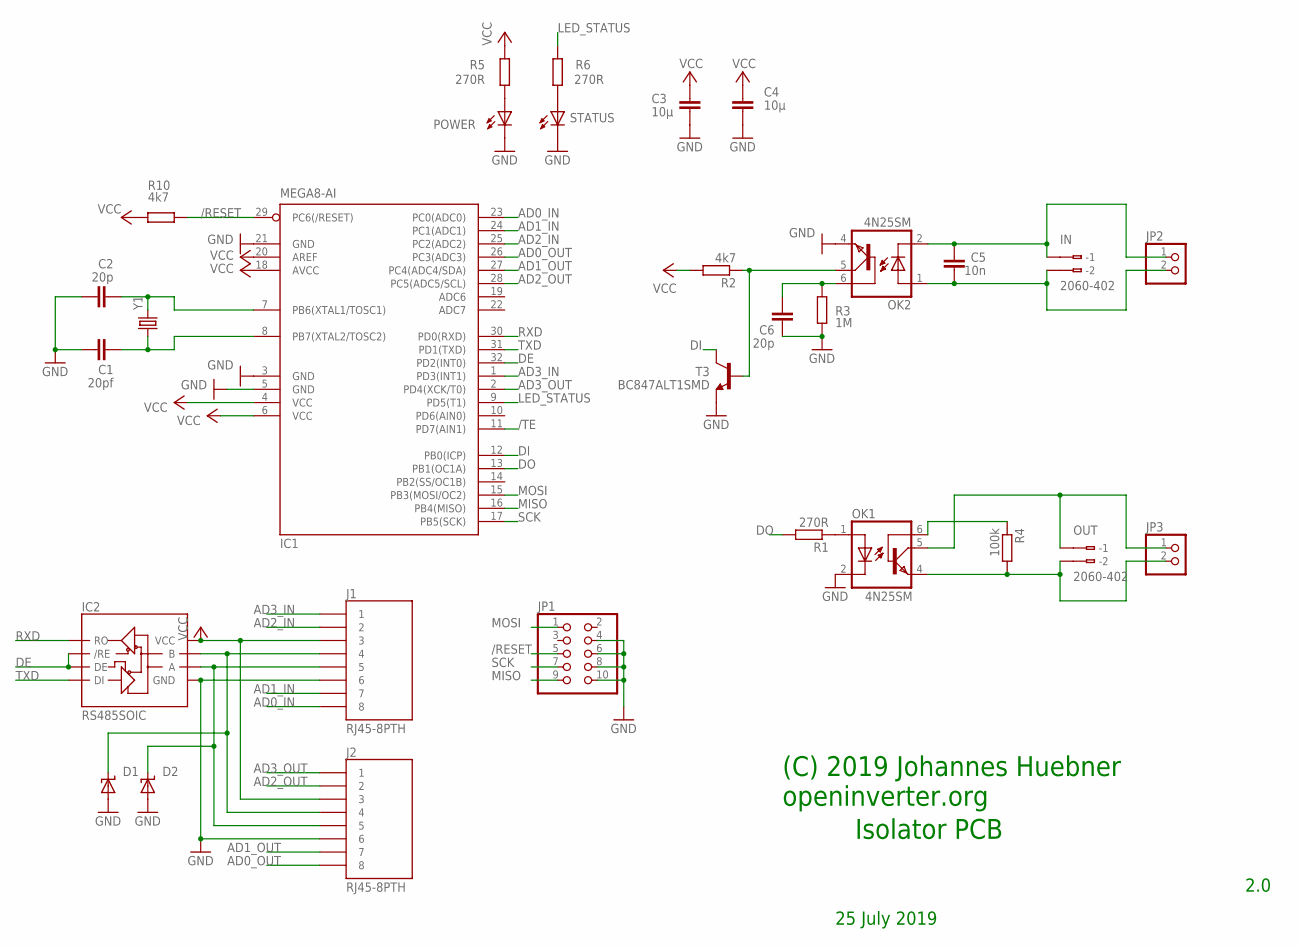
[picture p8: schematic Isolator2.0.sch]

Parts:
C1: 20pf; C0805
C2, C6: 20p; C0805
C3, C4: 10µ; C0805
C5: 10n; C0805
D1, D2: SUPPRESSOR-SMBJ; SMBJ
IC1: MEGA8-AI; TQFP32-08
IC2: RS485SOIC; SO08
IN: 2060-402
J1, J2: RJ45-8PTH; RJ45-8
JP1: PINHD-2X5; 2X05
JP2, JP3: PINHD-1X2; 1X02
OK1, OK2: 4N25SM; DIL6-SMD
OUT: 2060-402
POWER: LEDCHIP-LED0805; CHIP-LED0805
R1, R5, R6: 270R; M0805
R2, R10: 4k7; M0805
R3: 1M; M0805
R4: 100k; M0805
STATUS: LEDCHIP-LED0805; CHIP-LED0805
T3: BC847ALT1SMD; SOT23
Y1: CRYSTAL10.5X4.8; CRYSTAL-SMD-10.5X4.8-2PIN

Connections:
/RESET: IC1.29 (PC6(/RESET)), JP1.5, R10.2
/TE: IC1.11 (PD7(AIN1))
AD0_IN: IC1.23 (PC0(ADC0)), J1.8
AD0_OUT: IC1.26 (PC3(ADC3)), J2.8
AD1_IN: IC1.24 (PC1(ADC1)), J1.7
AD1_OUT: IC1.27 (PC4(ADC4/SDA)), J2.7
AD2_IN: IC1.25 (PC2(ADC2)), J1.2
AD2_OUT: IC1.28 (PC5(ADC5/SCL)), J2.2
AD3_IN: IC1.1 (PD3(INT1)), J1.1
AD3_OUT: IC1.2 (PD4(XCK/T0)), J2.1
DE: IC1.32 (PD2(INT0)), IC2.2 (/RE), IC2.3 (DE)
DI: IC1.12 (PB0(ICP)), T3.3 (C)
DO: IC1.13 (PB1(OC1A)), R1.2
GND: C1.1, C2.1, C3.2, C4.2, C6.1, D1.A, D2.A, IC1.3 (GND), IC1.5 (GND), IC1.21 (GND), IC2.5 (GND), J1.6, J2.6, JP1.4, JP1.6, JP1.8, JP1.10, OK1.2 (C), OK2.4 (EMI), POWER.C, R3.2, STATUS.C, T3.2 (E)
LED_STATUS: IC1.9 (PD5(T1)), R6.2
MISO: IC1.16 (PB4(MISO)), JP1.9
MOSI: IC1.15 (PB3(MOSI/OC2)), JP1.1
unnamed: OK1.1 (A), R1.1
unnamed: C6.2, OK2.6 (BAS), R3.1
unnamed: OK2.5 (COL), R2.1, T3.1 (B)
unnamed: OK1.6 (BAS), R4.1
unnamed: D1.C, IC2.7 (B), J1.4, J2.4
unnamed: JP3.2, OK1.4 (EMI), OUT.P22 (B-2), R4.2
unnamed: D2.C, IC2.6 (A), J1.5, J2.5
unnamed: POWER.A, R5.1
unnamed: R6.1, STATUS.A
unnamed: C2.2, IC1.7 (PB6(XTAL1/TOSC1)), Y1.P$2 (2)
unnamed: C1.2, IC1.8 (PB7(XTAL2/TOSC2)), Y1.P$1 (1)
unnamed: C5.1, IN.P22 (B-2), JP2.2, OK2.1 (A)
unnamed: C5.2, IN.P21 (B-1), JP2.1, OK2.2 (C)
unnamed: JP3.1, OK1.5 (COL), OUT.P21 (B-1)
RXD: IC1.30 (PD0(RXD)), IC2.1 (RO)
SCK: IC1.17 (PB5(SCK)), JP1.7
TXD: IC1.31 (PD1(TXD)), IC2.4 (DI)
VCC: C3.1, C4.1, IC1.4 (VCC), IC1.6 (VCC), IC1.18 (AVCC), IC1.20 (AREF), IC2.8 (VCC), J1.3, J2.3, R2.2, R5.2, R10.1

Notes on the sheet:
(C) 2019 Johannes Huebner openinverter.org
Isolator PCB
2.0
25 July 2019

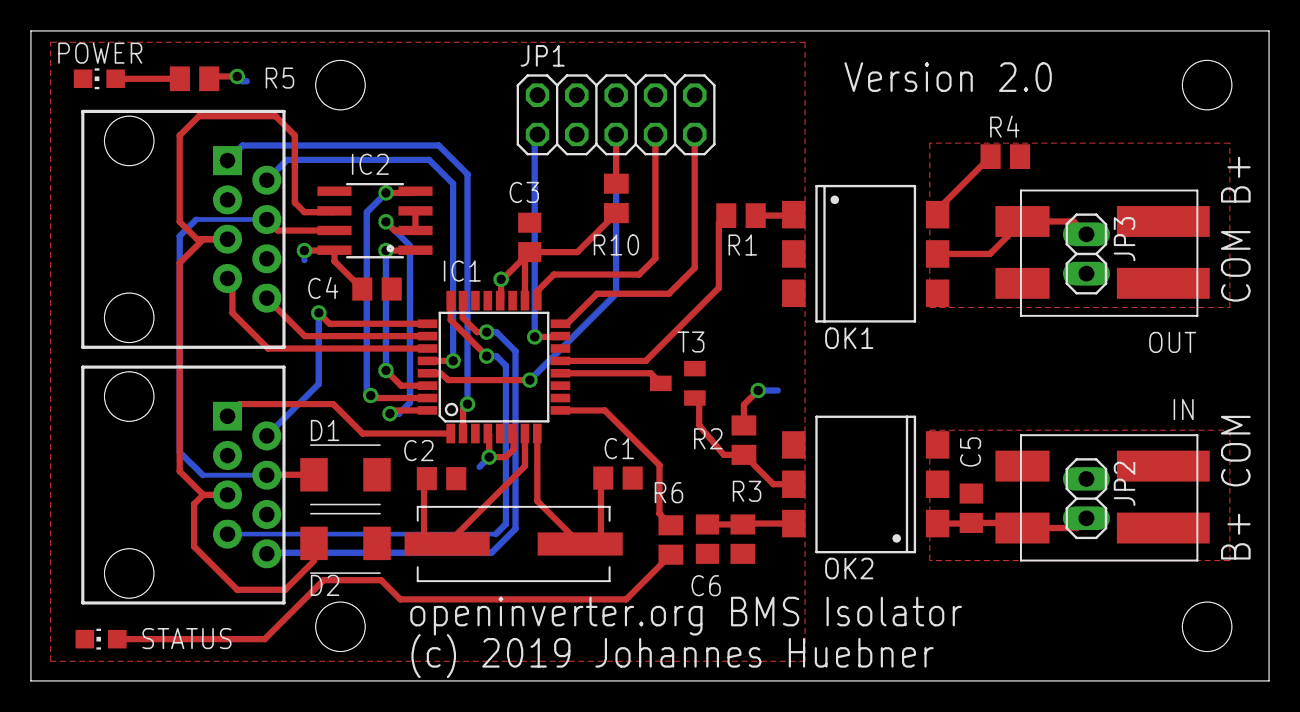
[picture p9: board Isolator2.0.brd from above]

Board: 2 copper layers, 80.0 x 42.0 mm, 30 parts (0 on the bottom side), 34 nets.
