jsphuebner/bms-hardware/Isolator Files/Blue Pill CAN Isolator/can-isolator-1.1.brd

## EAGLE design Isolator Files/Blue Pill CAN Isolator/can-isolator-1.1.brd (2020-02-24)

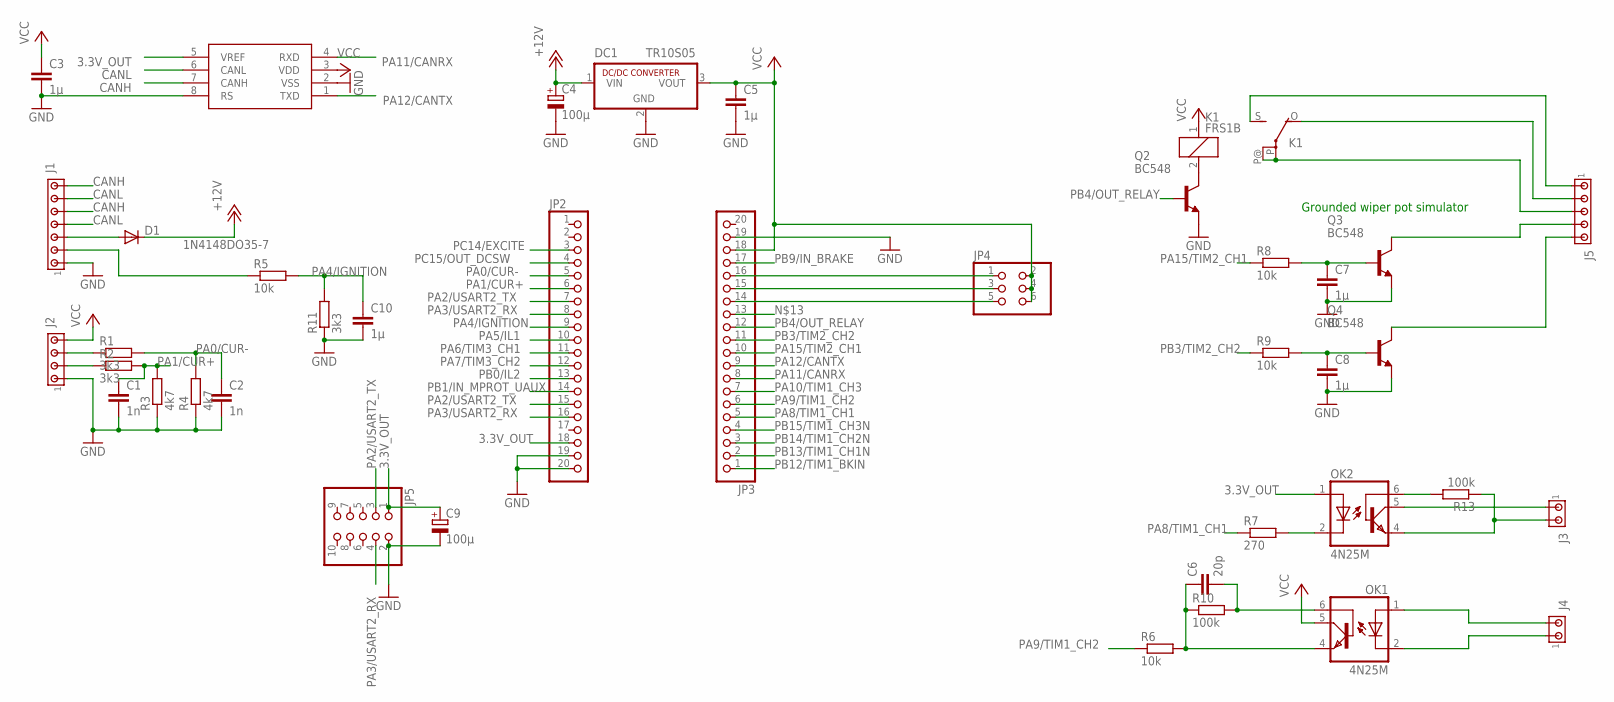
[picture p10: schematic can-isolator-1.1.sch]

Parts:
C1, C2: 1n; C025-024X044
C3, C5, C7, C8, C10: 1µ; C025-024X044
C4, C9: 100µ; E2-5
C6: 20p; C025-024X044
D1: 1N4148DO35-7; DO35-7
DC1: TR10S05; SIP3
IC1: MCP2562P; DIL08
J1: MTA07-100; 10X07MTA
J2: MTA04-100; 10X04MTA
J3, J4: MTA02-100; 10X02MTA
J5: MTA05-100; 10X05MTA
JP2, JP3: PINHD-1X20; 1X20
JP4: PINHD-2X3; 2X03
JP5: PINHD-2X5/90; 2X05/90
K1: FRS1B
OK1, OK2: 4N25M; DIL06
Q2, Q3, Q4: BC548; TO92-EBC
R1, R2, R11: 3k3; 0207/10
R3, R4: 4k7; 0207/10
R5, R6, R8, R9: 10k; 0207/10
R7: 270; 0207/10
R10, R13: 100k; 0207/10

Connections:
3.3V_OUT: C9.+, IC1.5 (VREF), JP2.18, JP5.1, OK2.1 (A)
+12V: C4.+, D1.C, DC1.1 (VIN)
CANH: IC1.7 (CANH), J1.5, J1.7
CANL: IC1.6 (CANL), J1.4, J1.6
GND: C1.2, C2.2, C3.2, C4.-, C5.2, C7.2, C8.2, C9.-, C10.2, DC1.2 (GND), IC1.2 (VSS), IC1.8 (RS), J1.1, J2.1, JP2.19, JP2.20, JP3.19, JP5.2, Q2.E, Q3.E, Q4.E, R3.1, R4.1, R11.1
IGNITION: J1.2, R5.1
unnamed: C7.1, Q3.B, R8.2
unnamed: J5.4, Q3.C
unnamed: C8.1, Q4.B, R9.2
unnamed: J5.5, Q4.C
unnamed: K1.2, Q2.C
unnamed: J5.3, K1.P, K1.P@
unnamed: J5.2, K1.O
unnamed: J5.1, K1.S
unnamed: OK2.2 (C), R7.2
unnamed: OK2.6 (BAS), R13.2
unnamed: J3.2, OK2.4 (EMI), R13.1
unnamed: J3.1, OK2.5 (COL)
unnamed: J4.2, OK1.1 (A)
unnamed: J4.1, OK1.2 (C)
unnamed: C6.2, OK1.6 (BAS), R10.2
unnamed: C6.1, OK1.4 (EMI), R6.2, R10.1
unnamed: JP3.14, JP4.5
unnamed: JP3.15, JP4.3
unnamed: JP3.16, JP4.1
unnamed: J2.3, R1.1
unnamed: J2.2, R2.1
unnamed: D1.A, J1.3
PA0/CUR-: C2.1, JP2.5, R1.2, R4.2
PA1/CUR+: C1.1, JP2.6, R2.2, R3.2
PA2/USART2_TX: JP2.7, JP2.15, JP5.3
PA3/USART2_RX: JP2.8, JP2.16, JP5.4
PA4/IGNITION: C10.1, JP2.9, R5.2, R11.2
PA5/IL1: JP2.10
PA6/TIM3_CH1: JP2.11
PA7/TIM3_CH2: JP2.12
PA8/TIM1_CH1: JP3.5, R7.1
PA9/TIM1_CH2: JP3.6, R6.1
PA10/TIM1_CH3: JP3.7
PA11/CANRX: IC1.4 (RXD), JP3.8
PA12/CANTX: IC1.1 (TXD), JP3.9
PA15/TIM2_CH1: JP3.10, R8.1
PB0/IL2: JP2.13
PB1/IN_MPROT_UAUX: JP2.14
PB3/TIM2_CH2: JP3.11, R9.1
PB4/OUT_RELAY: JP3.12, Q2.B
PB9/IN_BRAKE: JP3.17
PB12/TIM1_BKIN: JP3.1
PB13/TIM1_CH1N: JP3.2
PB14/TIM1_CH2N: JP3.3
PB15/TIM1_CH3N: JP3.4
PC14/EXCITE: JP2.3
PC15/OUT_DCSW: JP2.4
VCC: C3.1, C5.1, DC1.3 (VOUT), IC1.3 (VDD), J2.4, JP3.18, JP4.2, JP4.4, JP4.6, K1.1, OK1.5 (COL)

Notes on the sheet:
Grounded wiper pot simulator

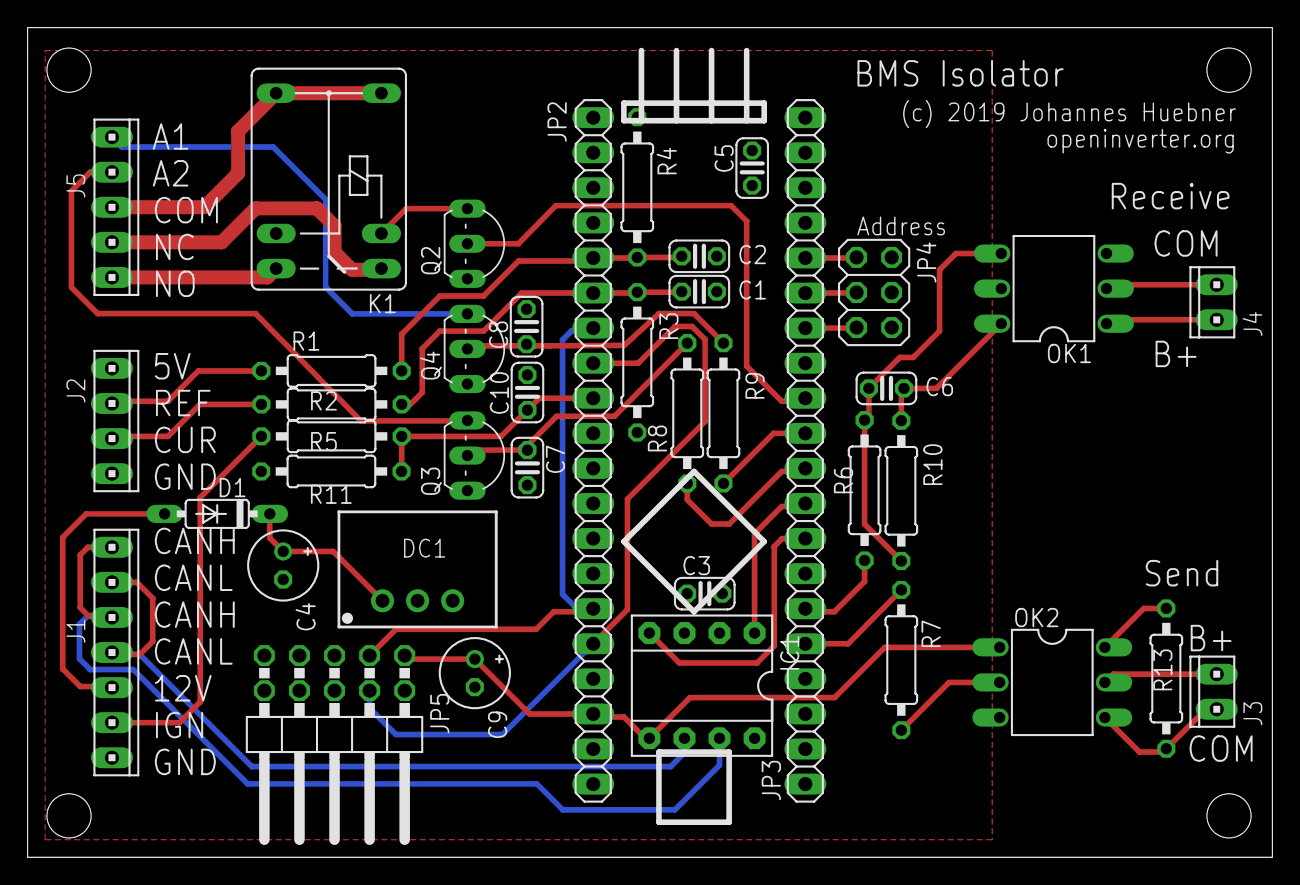
[picture p11: board can-isolator-1.1.brd from above]

Board: 2 copper layers, 90.1 x 60.1 mm, 40 parts (0 on the bottom side), 41 nets.
