jsphuebner/bms-hardware/(commit log)

2019-07-11 Changed comments and part numbers
    [BatMeas5.1.csv]
2019-07-11 Fixed dangling pin of R6
    [BatMeas5.1.brd]
2019-07-11 Update BatMeas5.1.csv
    Updated IC3 to AP2139AK-3.0TRG1 as ground current is less. Feels more important than a few pennys on cost
    [BatMeas5.1.csv]
2019-07-17 Created version 5.2 with dual connector population
    [BatMeas5.2 JST.brd, BatMeas5.2 JST.sch]
2019-07-18 Enlarged board to space new connectors
    Enlarged board, now 35x70mm. Moved bottom tracks other than ground plane to top side. Holes spaced 2.5mm in from edge of PCB (was 2.54mm)
    [BatMeas5.2 JST.brd]
2019-07-21 Minor updates and added maunfacturing files
    [BatMeas5.1.csv, BatMeas5.2 JST.brd, BatMeas5.2 JST.sch, BatMeas5.2 Manufacturing BOM.csv, BatMeas5.2.csv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]
2019-07-22 Updated Isolator board and added manufacturing files
    [Isolator2.0.brd, Isolator2.0.sch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]
2019-08-16 Added Isolator2.0 BOM
    Added Isolator BOM
    [Isolator2.0 BOM.csv]
2019-08-26 Update BatMeas5.2 Manufacturing BOM.csv
    Changed bleed resistors to 27R, specified voltage divider resistors as 1% tolerance
    [BatMeas5.2 Manufacturing BOM.csv]
2019-10-29 Isolator BOM Update
    Added manufacturer details. Updated crystal to 11.0592MHz and changed microcontroller to Atmega88P
    [Isolator2.0 BOM.csv]
2019-12-12 Removed Zener
    [BatMeas5.2 Manufacturing BOM.csv]
2020-01-02 Updated slave board: - Populate SMT programming header (also used for calibration) - select 1st board via jumper on programming header - B+ exports 3V3 instead of pack voltage -> no Zener needed. Res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
    [BOM.csv, BatMeas5.3 JST.brd, BatMeas5.3 JST.sch]
2020-01-02 Added CAN isolator schematic and layout
    [can-isolator-1.1.brd, can-isolator-1.1.sch]
2020-01-05 Minor CAN isolator PCB mods to improve track clearance. Added manufacturing data
    [can-isolator-1.1.brd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]
2020-02-05 Changed C5 to 10n
    [BOM.csv]
2020-02-24 Replaced JST comms connector by AVX or 4mm IDC wire to board connector Removed all THT options Removed holes below cell JST connector, made pads longer
    [BatMeas5.3 JST.brd, BatMeas5.3 JST.sch]
2020-02-24 Updated BOM
    [BOM.csv, BatMeas5.3 JST.brd, BatMeas5.3 JST.sch]
2020-03-01 Add BOM for Blue Pill CAN Isolator
    Create and add BOM for Blue Pill version of CAN Isolator
    [can-isolator-1.1 BOM.csv]
2020-03-01 Tidy up file structure
    [BOM.csv, BatMeas5.1.brd, BatMeas5.1.csv, BatMeas5.1.sch, BatMeas5.2 JST.brd, BatMeas5.2 JST.sch, BatMeas5.2 Manufacturing BOM.csv, BatMeas5.2.csv]
2020-03-01 Added SMT version of CAN isolator
    [Isolator CAN SMT bom with JLPCB Refs.csv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]
2020-03-02 Added manufacturing files
    [BatMeas5.3 JST.brd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]
2020-03-02 Changed value of C6 to 1u
    [BOM.csv]
2020-03-02 Added JLCPCB placement and BOM files
    [Isolator CAN SMT.kicad_pcb, Isolator CAN SMT.sch, batmeas-plc.xlsx, jlcpcb-bom.xlsx]
2020-05-02 Use Attiny44
    [BOM.csv]
2020-05-02 Use 3V3 reg with enable pin
    [jlcpcb-bom.xlsx]
2020-05-02 Move vias further away from opposite pin
    [BatMeas5.3 JST.brd]
2020-05-03 Add CAN Isolator V2 files
    CAN Isolator V2 created. Uses Cinch enclosure.
    [Isolator CAN SMT bom with JLPCB Refs.csv, Isolator CAN SMT v2 bom with JLCPCB Refs.csv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]
2020-08-06 Replaced 4M12/1M divider by 3M9/953k divider to stay in JLCPCBs part lib
    [Isolator CAN SMT v2-B_Cu.gbr, Isolator CAN SMT v2-B_Mask.gbr, Isolator CAN SMT v2-B_SilkS.gbr, Isolator CAN SMT v2-Edge_Cuts.gbr, Isolator CAN SMT v2-F_Cu.gbr, Isolator CAN SMT v2-F_Mask.gbr, Isolator CAN SMT v2-F_Paste.gbr, Isolator CAN SMT v2-F_SilkS.gbr]
2020-08-06 Update BOM and placement file after ordering
    [Isolator CAN SMT v2 bom with JLCPCB Refs.csv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]
2020-10-31 Changed R6 from 1k to 4k7, C5 from 10n to 1n, R14 from 100k to 47k
    [BOM.csv]
2021-05-05 BOM update
    [jlcpcb-bom.xlsx]
