jsphuebner/bms-hardware/(notices)

Notices in the files:
BatMeas5.2 JST.brd:
(c) 2019 J Huebner / A Martell
parts and their libraries:
SparkFun-Connectors: Licensing: CC v3.0 Share-Alike You are welcome to use this library for commercial purposes.
